Alkotikotik/Eclipse-10000/Eclipse-100000/FLARE-10K/PrecedenceTable.png

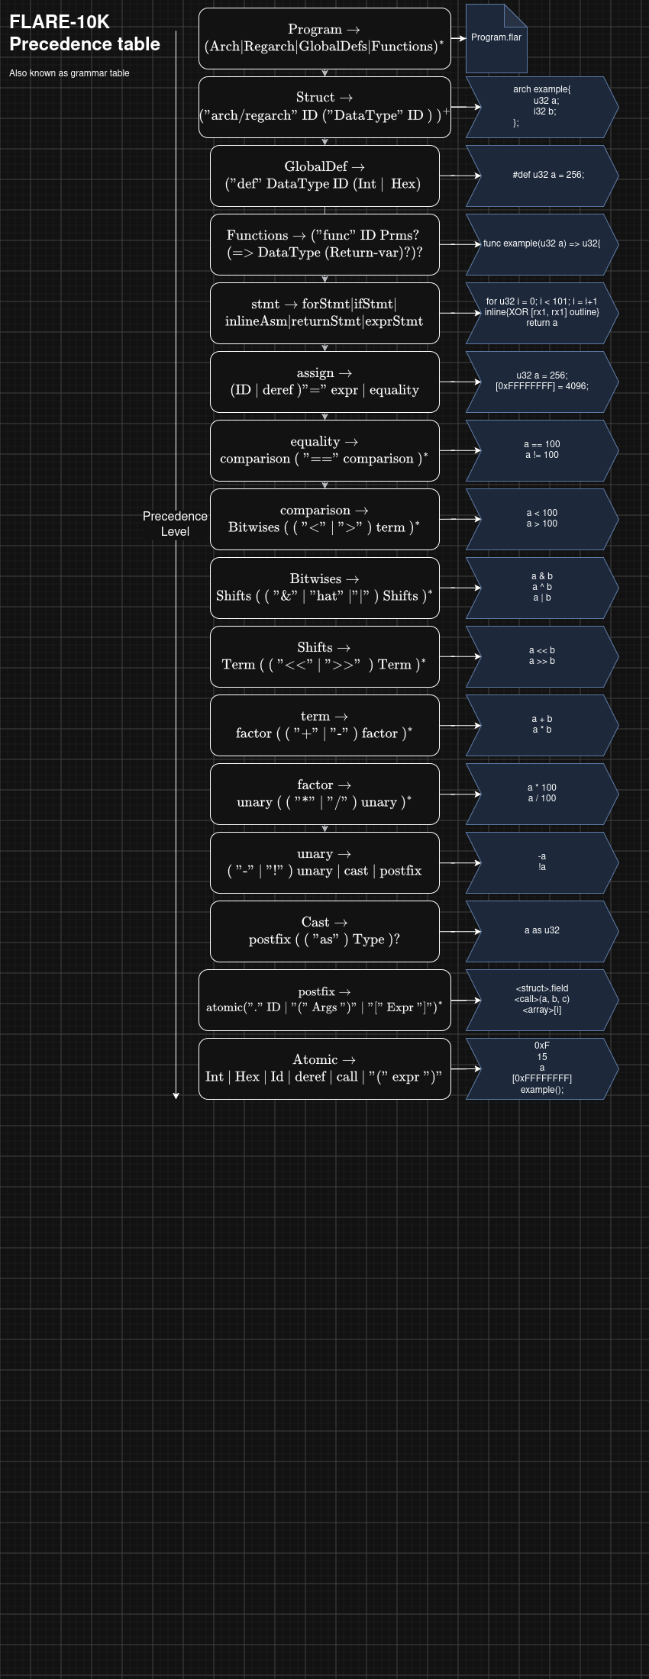
Eclipse-100000/FLARE-10K/PrecedenceTable.png
