Alkotikotik/Eclipse-10000/(list of files, drawings)

Other design files:
ALU.circ
Eclipse-10000.circ
