Alkotikotik/Eclipse-10000/Eclipse-100000/CU.sv

module CU(
    input logic clk,
    input logic reset,

    input logic [5:0] opcode,
    input logic [5:0] op_64,

    input logic [15:0] mmio_timer_reg,

    input logic current_kernel_mode,

    input logic [7:0] key_in,
    input logic isEX_valid,

    input logic timer_interrupt_commit,
    input logic key_interrupt_commit,

    output logic PCWrite,
    output logic GPRsWrite,

    output logic EPCWrite,
    output logic irq_taken,
    output logic isKernelMode,

    output logic timer_interrupt_taken,
    output logic key_interrupt_taken,

    output logic memRead,
    output logic memWrite,

    output logic [3:0] PCSrc, //pc+4, effective address
    output logic [2:0] GPRsSrc, //alu result, memory, spare

    output logic isCallState,

    output logic SPRWrite,
    output logic [2:0] SPRSrc
);

    //== CU ==//
    //So since I got rid of FSM CU currentely acts as purely decoding circuit
    //It runs in the EX

    logic [15:0] counter;
    logic timer_interrupt_pending;

    logic [7:0] prev_key_in;
    logic key_interrupt_pending;

    //Just interrupt handling
    always_ff @(posedge clk or posedge reset) begin
        if (reset) begin
            counter <= 16'd10000;
            timer_interrupt_pending <= 0;
            prev_key_in <= 8'hFF;
            key_interrupt_pending <= 0;
        end else begin
            if (counter == 16'd0) begin
                counter <= mmio_timer_reg;
                timer_interrupt_pending <= 1;
            end else begin
                counter <= counter - 1;
            end

            if (timer_interrupt_commit)
                timer_interrupt_pending <= 0;

            prev_key_in <= key_in;
            if (key_interrupt_commit)
                key_interrupt_pending <= 0;
            if (key_in != 8'hFF && key_in != prev_key_in)
                key_interrupt_pending <= 1;
        end
    end

    always_comb begin
        GPRsWrite = 0;
        EPCWrite = 0; isKernelMode = current_kernel_mode;
        memRead = 0; memWrite = 0;
        PCSrc = 4'b0000; GPRsSrc = 3'b000;
        isCallState = 0;
        SPRWrite = 0; SPRSrc = 3'b000;
        PCWrite = 0;
        timer_interrupt_taken = 0;
        key_interrupt_taken = 0;
        irq_taken = 0;

        unique case (opcode[5:4])
            2'b00: begin // ALU R/B-type default, and bigass 64 bit decoder, for every 64bit instr
                if (opcode == 6'b000000) begin
                    unique case (op_64)
                        6'b000000: ; //NOP
                        6'b010001: begin //LMA
                            GPRsSrc = 3'b110;
                            GPRsWrite = 1;
                        end
                        6'b010000: begin
                            memWrite = 1;
                        end
                        6'b011111: begin
                            memRead = 1;
                            GPRsSrc = 3'b001;
                            GPRsWrite = 1;
                        end
                        6'b011110: begin //MDLX
                            memRead = 1;
                            GPRsSrc = 3'b001;
                            GPRsWrite = 1;
                        end
                        6'b011101: begin //MDCX
                            GPRsSrc = 3'b101;
                            GPRsWrite = 1;
                        end
                        6'b011100: begin //MDSX
                            memWrite = 1;
                        end
                        default ;
                    endcase
                end else begin
                    GPRsWrite = 1;
                end
            end
            2'b11: begin // conditional branch default
                PCSrc = 4'b0000;
                //The CU no longer decides whether branch was taken, bc its
                //now in VER
            end
            2'b01: begin // LOAD-imm
                if (opcode == 6'b010001) begin
                    GPRsWrite = 1;
                    GPRsSrc = 3'b011; // LOAD rx0,imm18
                end
            end
            2'b10: ;
            default: ;
        endcase

        //Basically stays the same
        unique case (opcode)
            6'b010010: begin //SYS
                EPCWrite = 1;
                isKernelMode = 1;
                PCSrc = 4'b0010;
                PCWrite = 1;
            end
            6'b111101: begin //RETU
                isKernelMode = 0;
                PCSrc = 4'b0011;
                PCWrite = 1;
            end
            6'b111000: begin //CALL
                PCSrc   = 4'b0001;
                PCWrite = 1;
                isCallState = 1;
                SPRSrc = 3'b100;
                SPRWrite = 1;
            end
            6'b010000: begin //RET
                PCSrc   = 4'b0101;
                PCWrite = 1;
                SPRSrc = 3'b101;
                SPRWrite = 1;
            end
            6'b110111: begin //JR
                PCSrc   = 4'b0111;
                PCWrite = 1;
            end
            6'b111111: begin //JMP
                PCSrc   = 4'b0001;
                PCWrite = 1;
            end
            6'b101010: begin // SPRSET
                SPRSrc = 3'b011;
                SPRWrite = 1;
            end
            6'b101011: begin // SPRADD
                SPRSrc = 3'b110;
                SPRWrite = 1;
            end
            6'b101100: begin // SPRSUB
                SPRSrc = 3'b111;
                SPRWrite = 1;
            end
            6'b100011: begin // LDR
                memRead = 1;
                GPRsSrc = 3'b001;
                GPRsWrite = 1;
            end
            6'b100111: begin // STR
                memWrite = 1;
            end
            6'b100100: begin // PUSH
                memWrite = 1;
                SPRSrc = 3'b100;
                SPRWrite = 1;
            end
            6'b100101: begin // POP
                memRead = 1;
                GPRsSrc = 3'b001;
                GPRsWrite = 1;
                SPRSrc = 3'b101;
                SPRWrite = 1;
            end
            6'b101000: begin // SPRLDR
                memRead = 1;
                GPRsSrc = 3'b001;
                GPRsWrite = 1;
            end
            6'b101001: begin // SPRSTR
                memWrite = 1;
            end
            6'b101101: begin // SPRLEA — computed value, no memory access
                GPRsSrc = 3'b101;
                GPRsWrite = 1;
            end
            6'b111100: begin //RNG
                GPRsWrite = 1;
                GPRsSrc = 3'b111;
            end
            default: ; //Should cover everything
        endcase

        //Interrupt override whatever was in the current EX now checking on
        //every cycle instead of only between states, also it is gated by
        //!PCWrite so in base of branch nothing would break
        if (isEX_valid && !isKernelMode) begin
            if (timer_interrupt_pending) begin
                EPCWrite = 1; isKernelMode = 1; PCSrc = 4'b0100; PCWrite = 1;
                timer_interrupt_taken = 1;
                irq_taken = 1;
                GPRsWrite = 0; memWrite = 0; SPRWrite = 0; memRead = 0; //Forget to include memRead = 0 previosely
            end else if (key_interrupt_pending) begin
                EPCWrite = 1; isKernelMode = 1; PCSrc = 4'b1000; PCWrite = 1;
                key_interrupt_taken = 1;
                irq_taken = 1;
                GPRsWrite = 0; memWrite = 0; SPRWrite = 0; memRead = 0;
            end
        end
    end

    //== End of CU(god do I love that thing) ==//
endmodule
