Alkotikotik/Eclipse-10000/(commit log)

2026-07-01 initial one
    [adder.circ]
2026-07-02 new arch
    [ALU.circ, adder.circ, alu.circ]
2026-07-03 4bit ALU
    [ALU.circ]
2026-07-03 16Bit CLA
    [Eclipse-10000.circ]
2026-07-04 ALU coming together
    [Eclipse-10000.circ]
2026-07-05 ALU doneeeeee(for now)
    [Eclipse-10000.circ]
2026-07-05 dpesn't work
    [Eclipse-10000.circ]
2026-07-05 2+2 actually works, its pretty insane
    [Eclipse-10000.circ]
2026-07-08 IT WORKS
    [Eclipse-10000.circ]
2026-07-08 commit message
    [Eclipse-10000.circ]
2026-07-08 Works again
    [Eclipse-10000.circ]
2026-07-09 fixed a bug
    [Eclipse-10000.circ]
2026-07-09 getting there
    [Eclipse-10000.circ]
2026-07-09 starting WT
    [Eclipse-10000.circ]
2026-07-10 logisim CPU done?
    [Eclipse-10000.circ]
2026-07-10 forgot to commit
    [Eclipse-10000.circ]
2026-07-10 fibochachi works
    [Eclipse-10000.circ]
2026-07-11 starting Eclipse-100000
    [Eclipse-10000.circ]
2026-07-12 adapted assembler
2026-07-12 adapted assembler1
    [Eclipse-10000.circ]
2026-07-13 updates assembler
2026-07-15 final fixes, moving onto next part
    [CORE.sv, RAM.sv]
2026-07-20 semantic finally done, didn't like it
    [main.rs]
2026-07-23 it doesn't but im still proud
    [ALU.sv, CORE.sv, CU.sv, RAM.sv, main.rs]
2026-07-23 yeah bro its some kind of miracle that it doesn't work
    [CU.sv, GPRs.sv, main.rs]
2026-07-26 starting codegen
    [Eclipse-10000.circ]
2026-07-27 updated compiler couple of new features
    [Eclipse-10000.circ]
2026-08-04 couple of bugs left
2026-08-08 like why doesn't it work
    [main.rs]
2026-08-09 this was a CPU bug...
    [CU.sv]
2026-08-18 div doesn't work atm
    [ALU.sv, CORE.sv, main.rs]
2026-08-22 stage 1 kinda done
2026-08-24 god damn it forgot to commit I fixed the bug though it was a nightmare tbh
    [CORE.sv, CU.sv]
2026-08-26 uncond resolved in IF, and rainbow now runs in less than a second
    [CORE.sv]
2026-08-28 fixed small bug and now capital works??
    [CORE.sv]
2026-09-02 mem wasn't doing too much aswell so I changed it
    [CORE.sv, RAM.sv, VRAM.sv, sim_debug.cpp, sim_main.cpp]
2026-09-04 starting fused
2026-09-05 starting fused1
2026-09-06 still couple of bugs
    [CORE.sv, main.rs]
2026-09-10 compiles and it didn't break anything
    [ALU.sv, CORE.sv]
2026-09-11 alright well one critical path fixed, but its still 22ns
    [ALU.sv]
2026-09-17 goddamn it moving branch to MEM didn't work
    [CORE.sv, CU.sv, sim_main.cpp]
2026-09-17 fixed 1path new one appears and again and again
    [ALU.sv]
2026-09-19 fixed lil vivado warning
    [ALU.sv, CORE.sv]
2026-09-26 fixed bug caused by BE
    [CORE.sv]
2026-10-01 doesn't work atm, but it should shortly
    [EMI_600.sv, full_oserder.sv]
2026-10-03 next calib stage
2026-10-06 EMI pipeline done, only testing left
    [EMI_600.sv]
2026-10-07 EMI-1200 might be better than MIG
    [EMI_1200.sv]
2026-10-09 i think its just vivado noise
    [CORE.sv]
2026-10-18 testing XADC samples randomness
2026-10-23 might switch to double core cpu
2026-11-09 started int ops stage 2
